Ogbonna-Joseph/Thingy-Design/Image/design00001.png

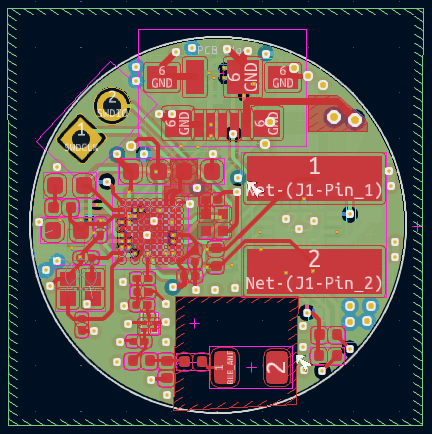
Image/design00001.png
