Ogbonna-Joseph/Thingy-Design/Image/3d007.png

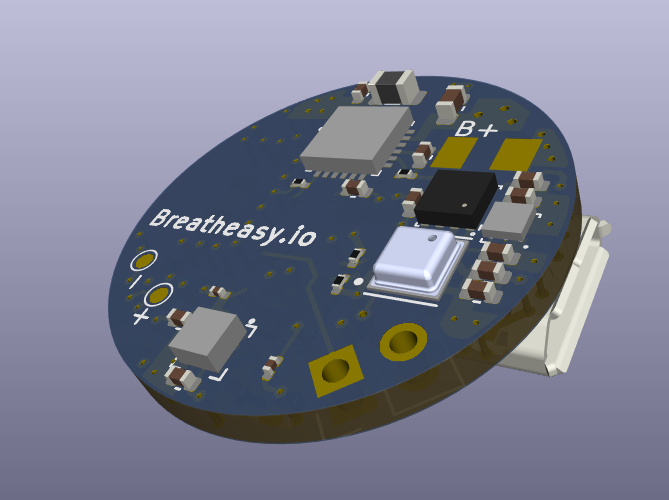
Image/3d007.png
