Ogbonna-Joseph/Thingy-Design/Image/3d002.png

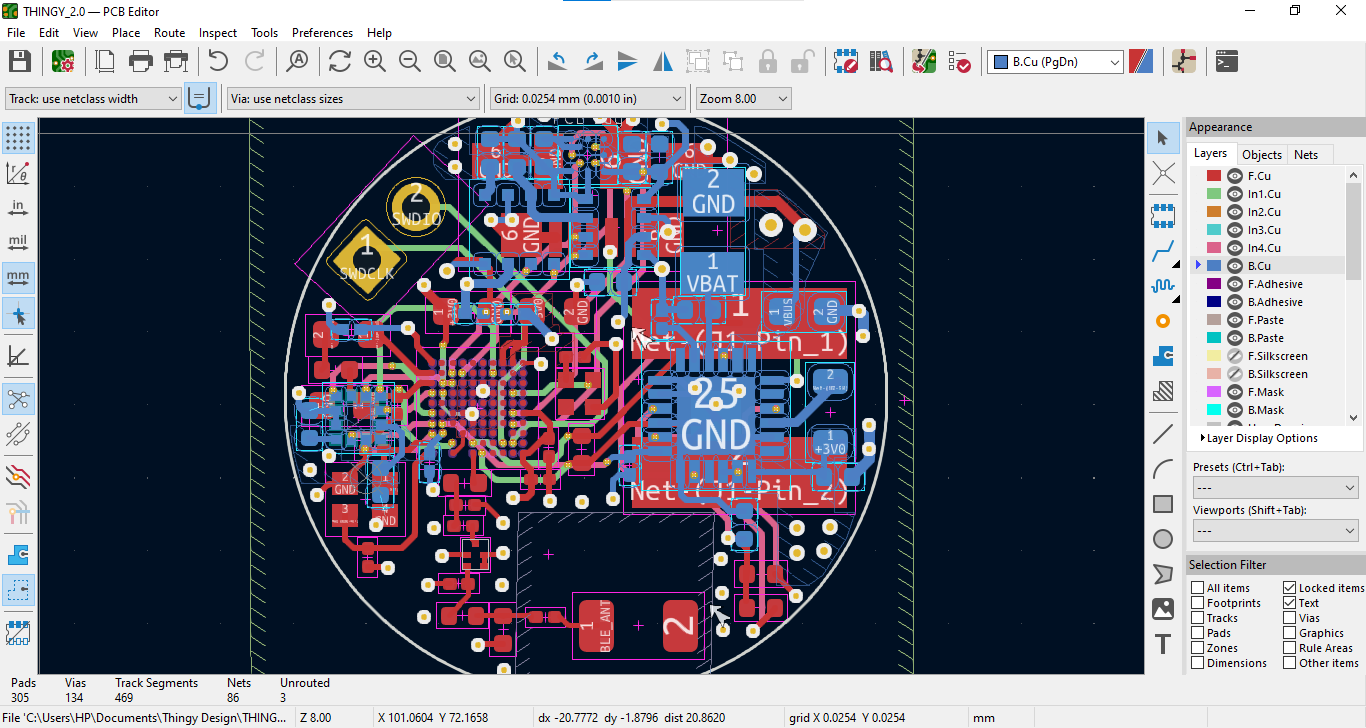
Image/3d002.png
