Ogbonna-Joseph/Thingy-Design/Image/3d003.png

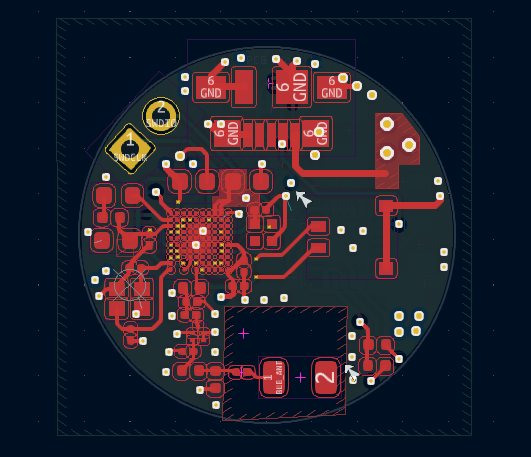
Image/3d003.png
