Ogbonna-Joseph/Thingy-Design/Image/3d004.png

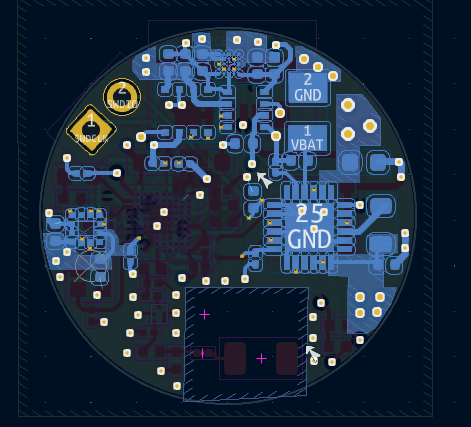
Image/3d004.png
