Ogbonna-Joseph/Thingy-Design/Image/3d005.png

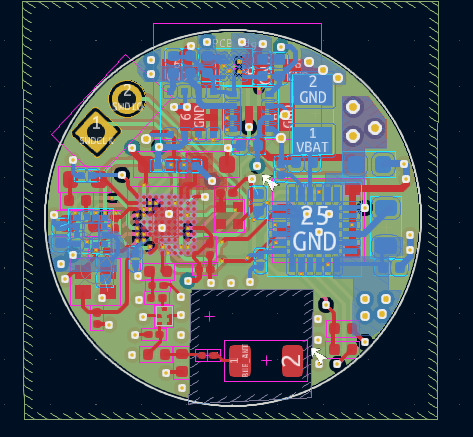
Image/3d005.png
