Ogbonna-Joseph/Thingy-Design/Image/3d006.png

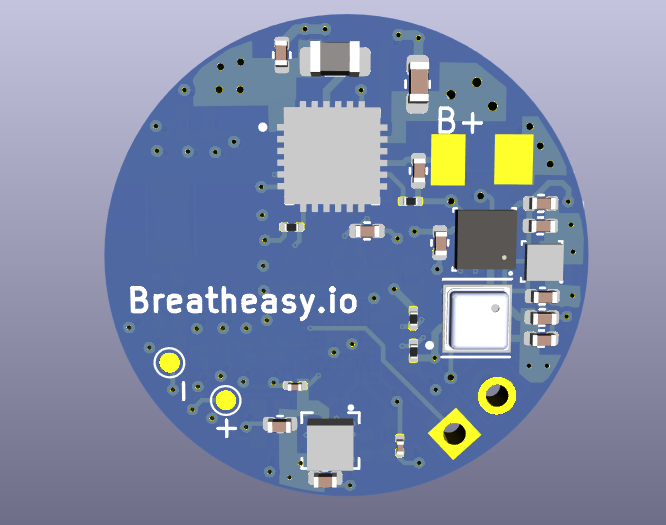
Image/3d006.png
