Ogbonna-Joseph/Thingy-Design/Image/3d008.png

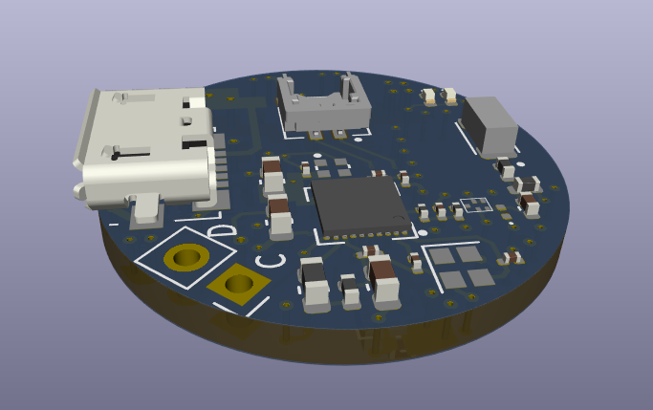
Image/3d008.png
