Ogbonna-Joseph/Thingy-Design/Image/3d009.png

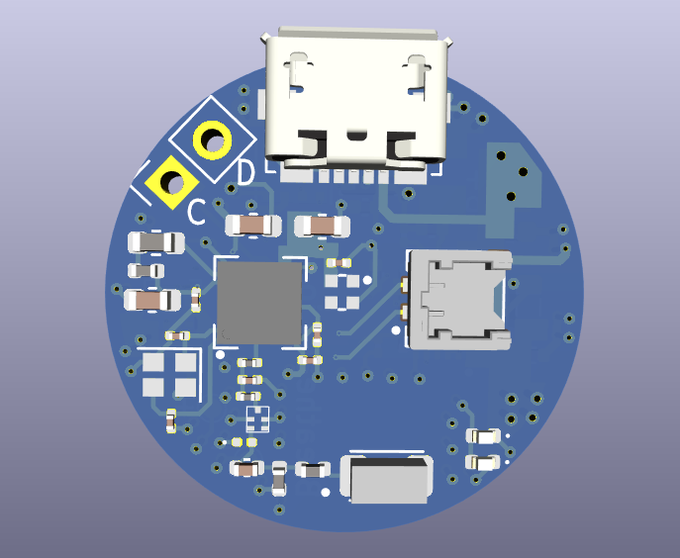
Image/3d009.png
