Ogbonna-Joseph/Thingy-Design/Image/design0001.png

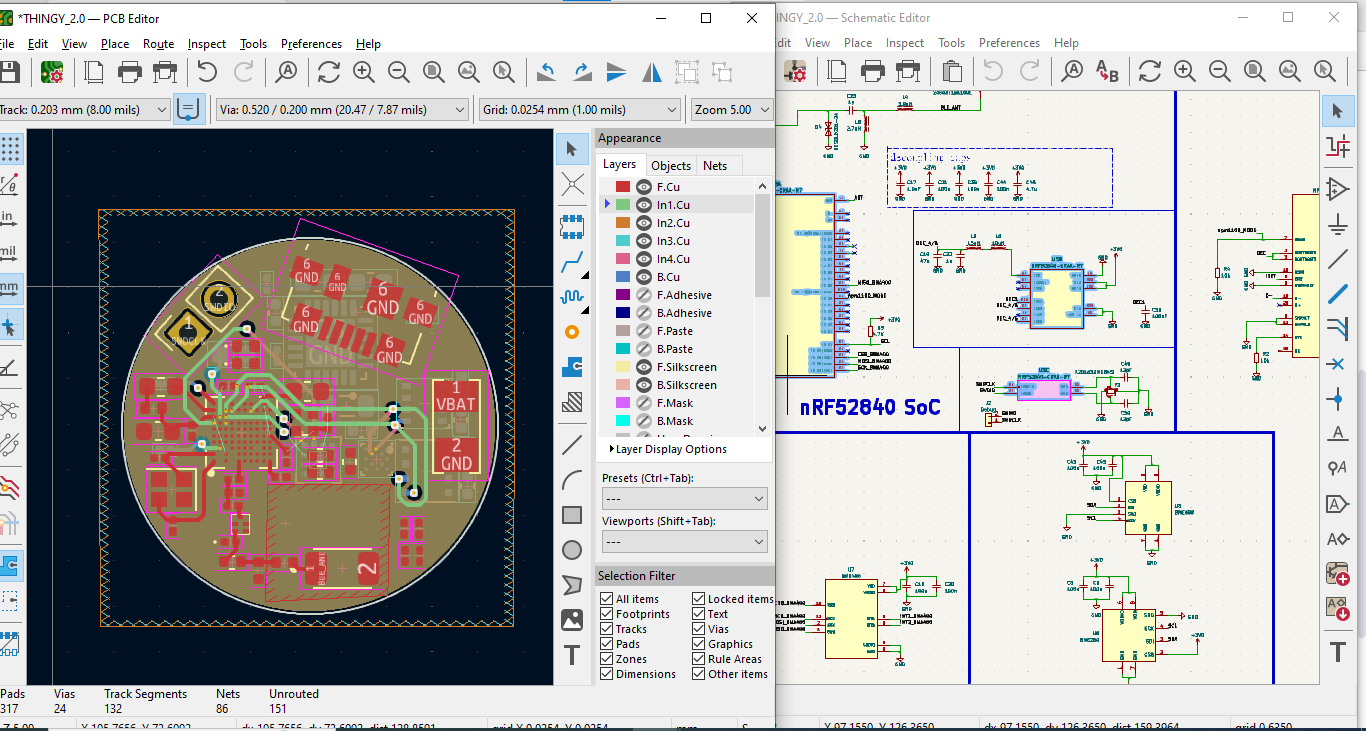
Image/design0001.png
