Ogbonna-Joseph/Thingy-Design/Image/design002.png

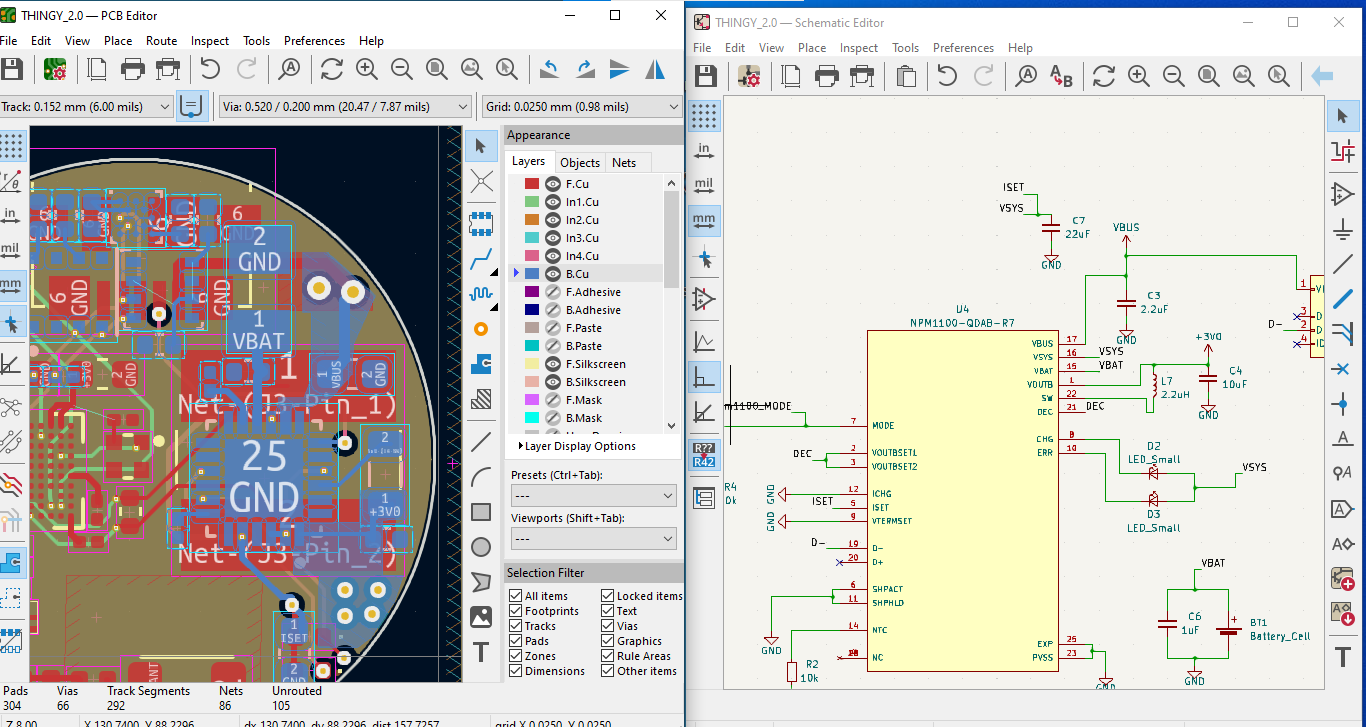
Image/design002.png
