Ogbonna-Joseph/Thingy-Design/Image/Impedence.png

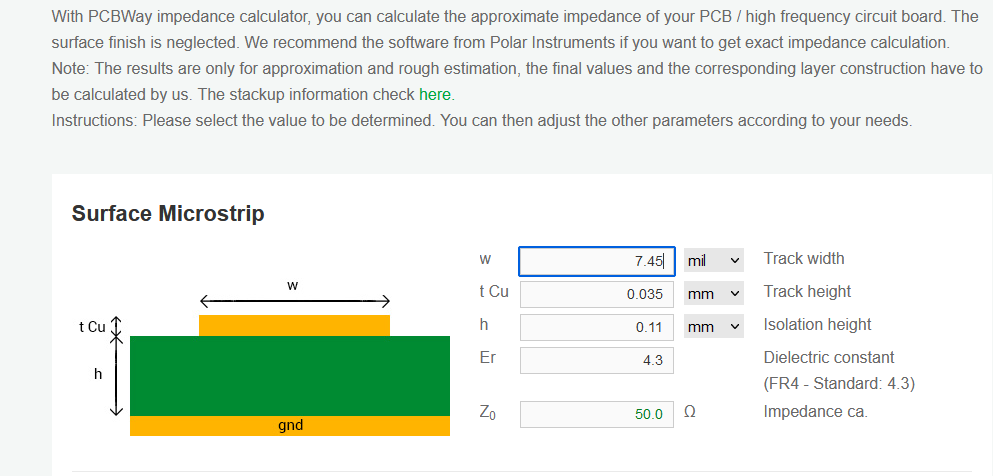
Image/Impedence.png
