Ogbonna-Joseph/Thingy-Design/Image/pcb001.png

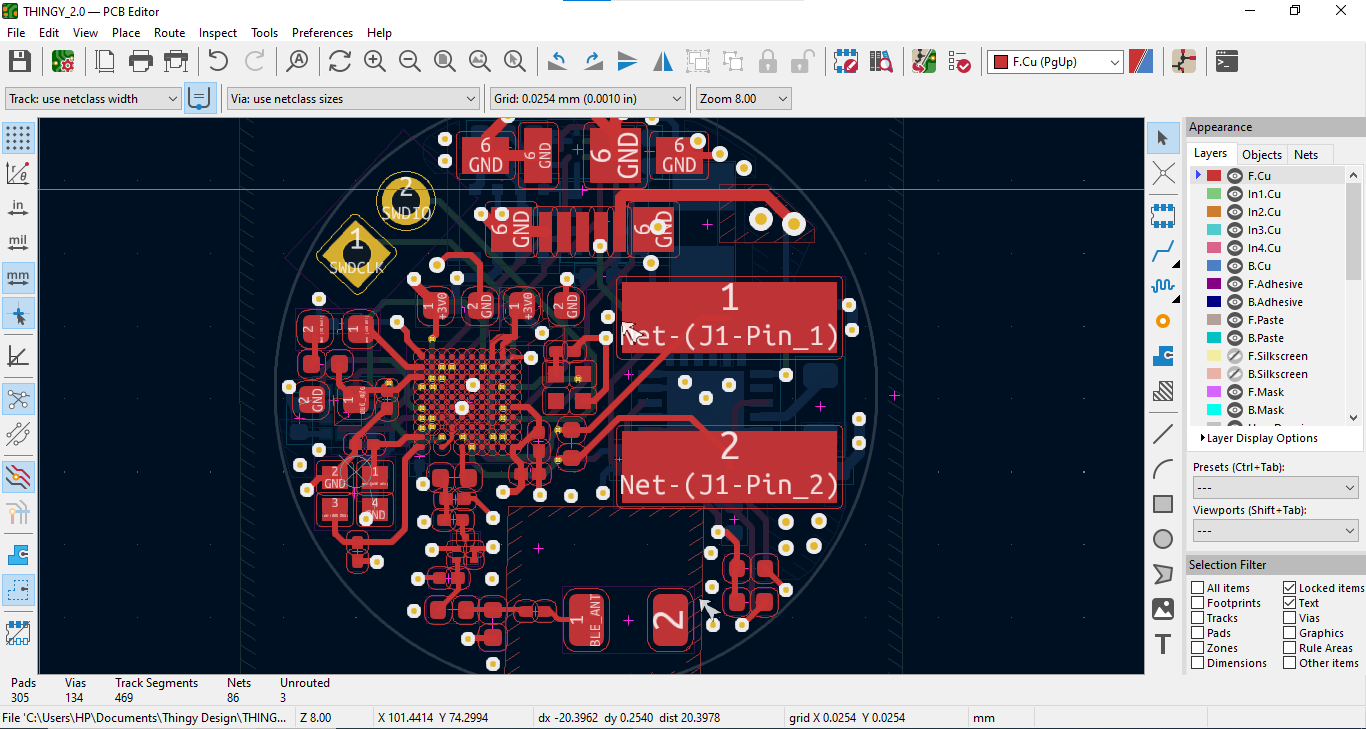
Image/pcb001.png
