Ogbonna-Joseph/Thingy-Design/Image/stackup.png

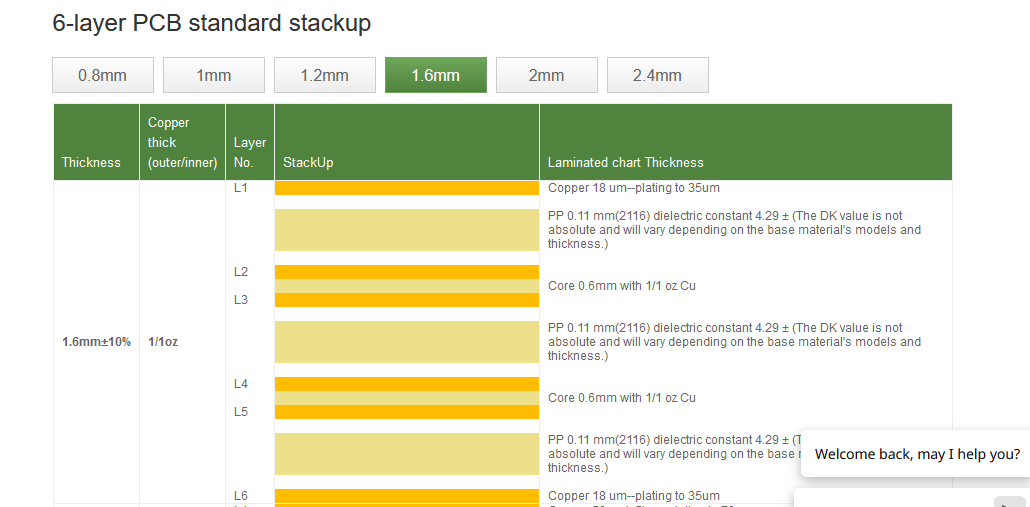
Image/stackup.png
