Ogbonna-Joseph/Thingy-Design/Symbols and Footprint Libs/2450AT18A100E/2450AT18A100E.step

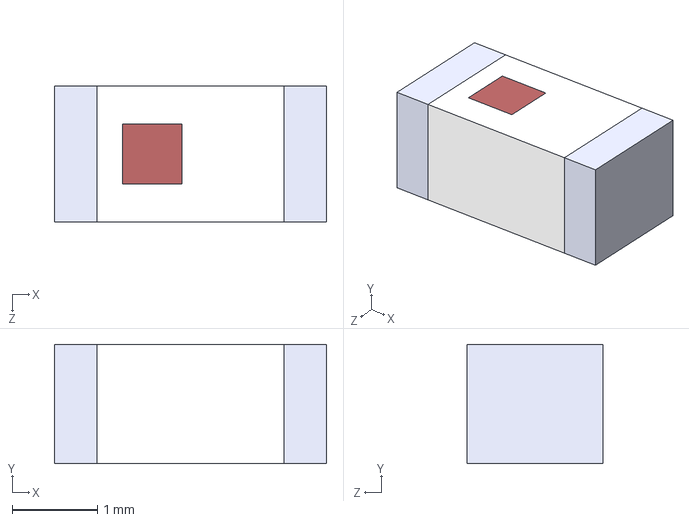
[picture p15: CAD file, 2023-09-10]
Symbols and Footprint Libs/2450AT18A100E/2450AT18A100E.step
3.20 x 1.40 x 1.60 mm
