Ogbonna-Joseph/Thingy-Design/Symbols and Footprint Libs/2450AT18D0100E/2450AT18D0100E.step

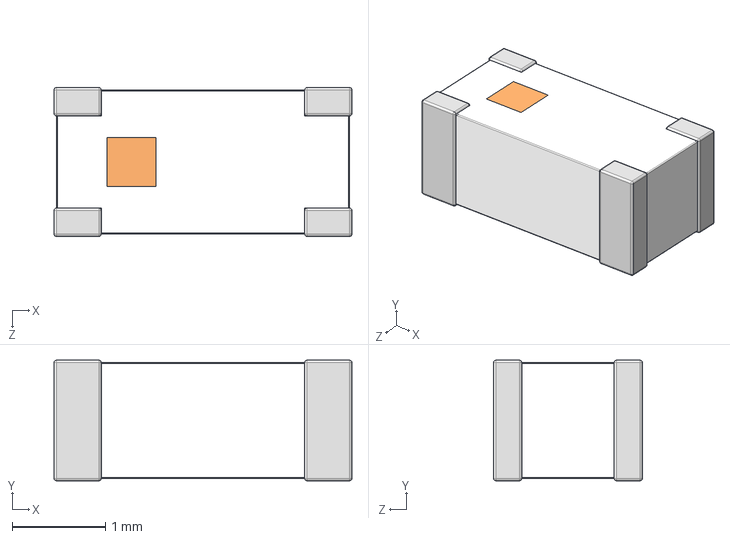
[picture p16: CAD file, 2023-09-10]
Symbols and Footprint Libs/2450AT18D0100E/2450AT18D0100E.step
3.20 x 1.30 x 1.60 mm
