Ogbonna-Joseph/Thingy-Design/Symbols and Footprint Libs/BM02B-ACHSS-GAN-TF_LF__SN_/BM02B-ACHSS-GAN-TF_LF__SN_.step

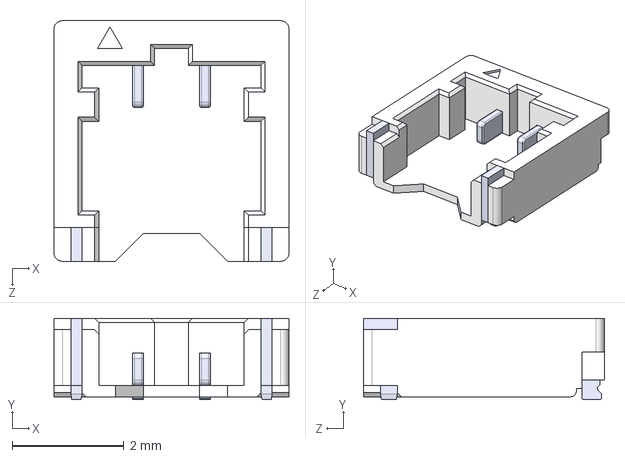
[picture p17: CAD file, 2023-09-10]
Symbols and Footprint Libs/BM02B-ACHSS-GAN-TF_LF__SN_/BM02B-ACHSS-GAN-TF_LF__SN_.step
4.20 x 1.45 x 4.30 mm
