Ogbonna-Joseph/Thingy-Design/Symbols and Footprint Libs/BMA400/BMA400.step

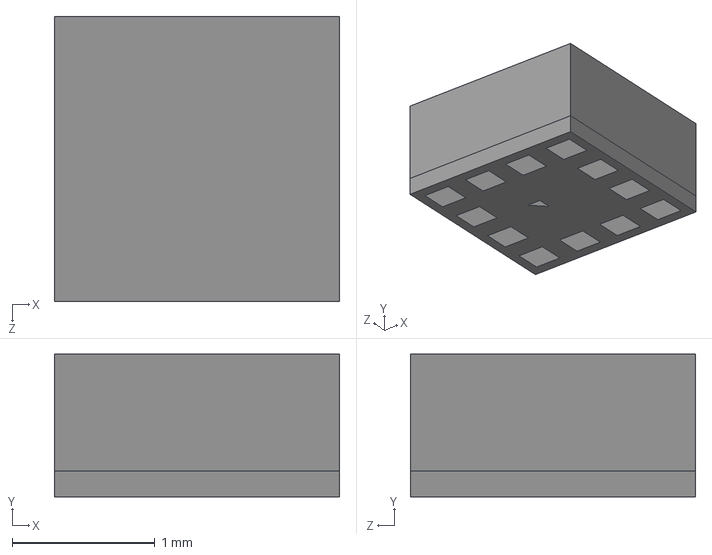
[picture p18: CAD file, 2023-09-10]
Symbols and Footprint Libs/BMA400/BMA400.step
2.00 x 1.00 x 2.00 mm
