Ogbonna-Joseph/Thingy-Design/Symbols and Footprint Libs/BME280/BME280.step

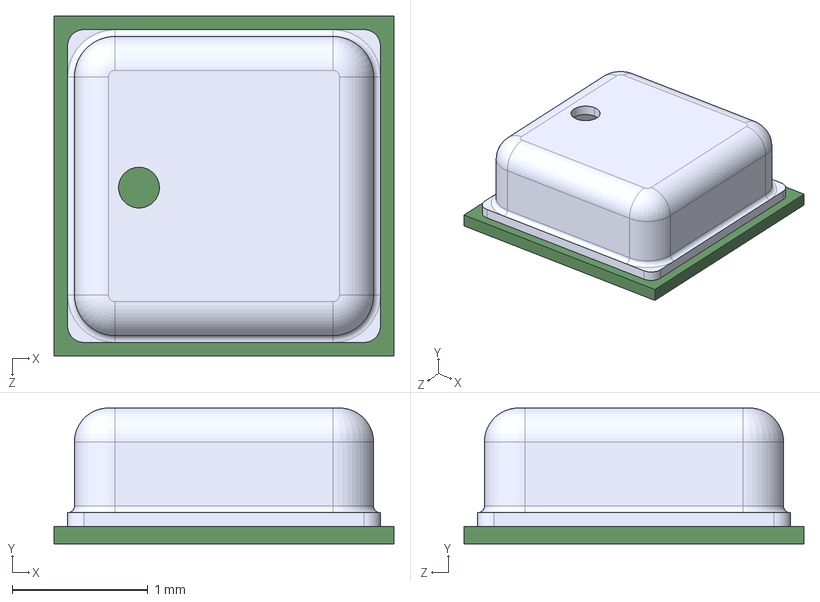
[picture p19: CAD file, 2023-09-10]
Symbols and Footprint Libs/BME280/BME280.step
2.50 x 1.00 x 2.50 mm
