Ogbonna-Joseph/Thingy-Design/Symbols and Footprint Libs/BME688/BME688.step

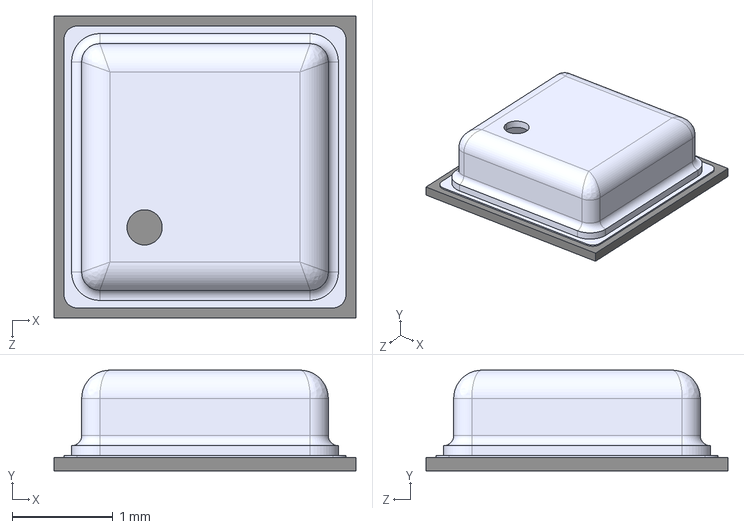
[picture p20: CAD file, 2023-09-10]
Symbols and Footprint Libs/BME688/BME688.step
3.00 x 1.00 x 3.00 mm
