Ogbonna-Joseph/Thingy-Design/Symbols and Footprint Libs/BMM150/BMM150.step

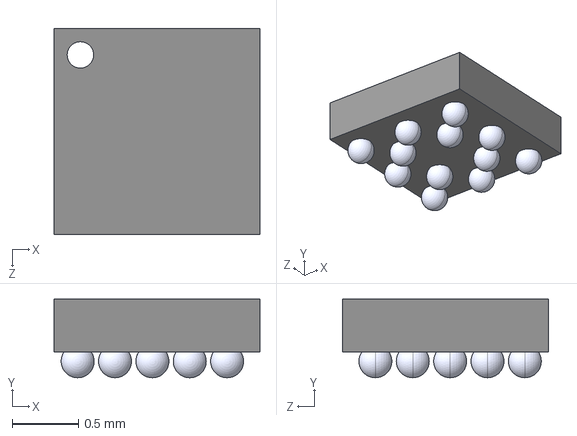
[picture p21: CAD file, 2023-09-10]
Symbols and Footprint Libs/BMM150/BMM150.step
1.56 x 0.595 x 1.56 mm
Body^BMM150
Pin^BMM150 x 12
