Ogbonna-Joseph/Thingy-Design/Symbols and Footprint Libs/EZA-EG1N50AC/EZA-EG1N50AC.step

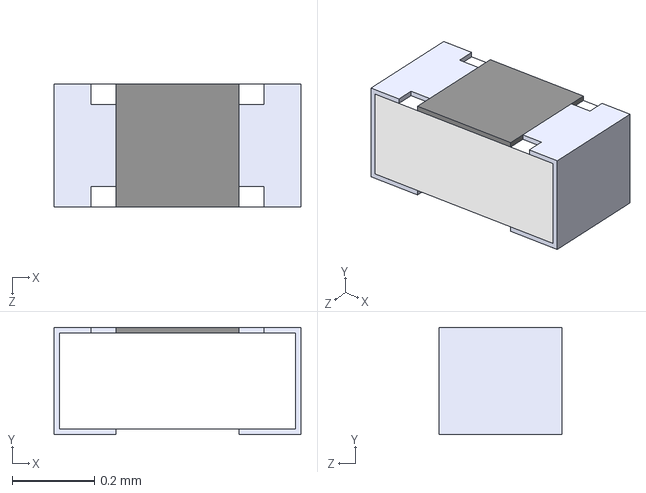
[picture p22: CAD file, 2023-09-10]
Symbols and Footprint Libs/EZA-EG1N50AC/EZA-EG1N50AC.step
0.6 x 0.26 x 0.3 mm
