Ogbonna-Joseph/Thingy-Design/Symbols and Footprint Libs/NPM1100-QDAB-R7/NPM1100-QDAB-R7.step

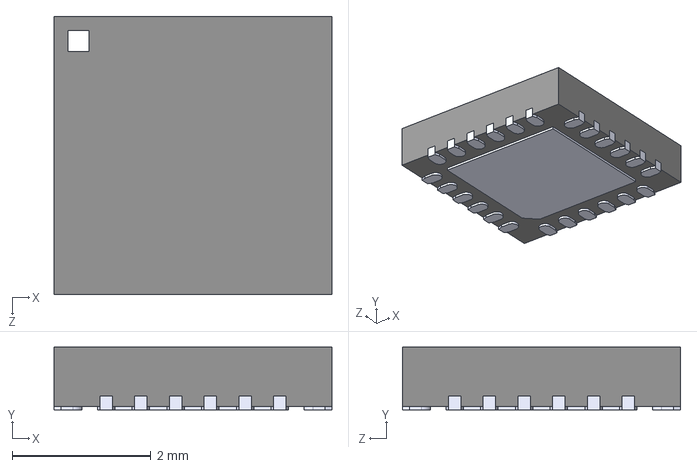
[picture p23: CAD file, 2023-09-10]
Symbols and Footprint Libs/NPM1100-QDAB-R7/NPM1100-QDAB-R7.step
4.00 x 0.9 x 4.00 mm
