Ogbonna-Joseph/Thingy-Design/Symbols and Footprint Libs/X201632MKB4SI.stp

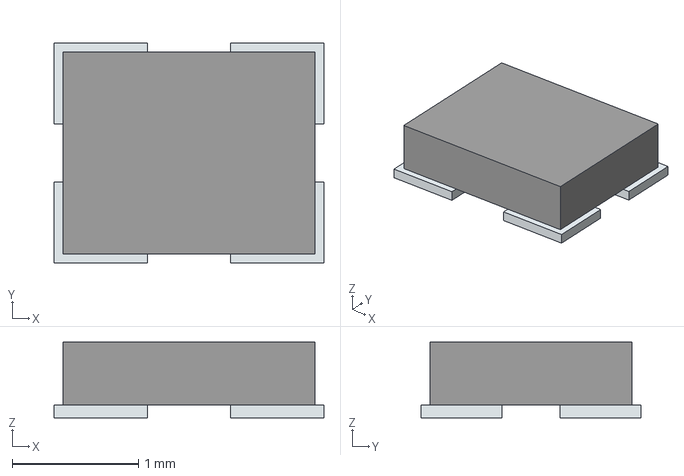
[picture p24: CAD file, 2023-09-10]
Symbols and Footprint Libs/X201632MKB4SI.stp
2.14 x 1.74 x 0.6 mm
Pins
