Ogbonna-Joseph/Thingy-Design/Symbols and Footprint Libs/NRF52840-CKAA-R7.stp

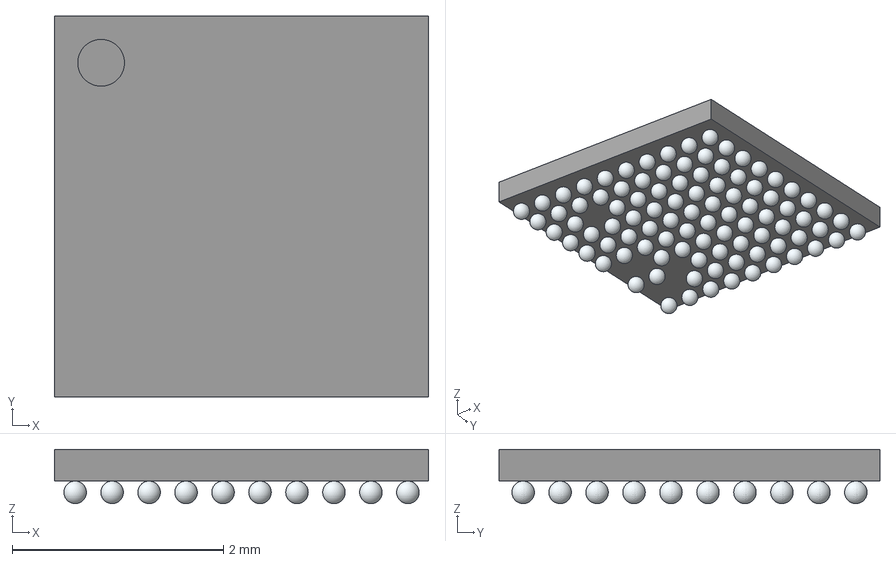
[picture p25: CAD file, 2023-09-10]
Symbols and Footprint Libs/NRF52840-CKAA-R7.stp
3.54 x 3.61 x 0.514 mm
A1
A2
A3
A4
A5
A6
A7
A8
A9
A10
B3
B4
B5
B6
B7
B8
B9
B10
C1
C2
C4
C5
C6
C7
C8
C9
C10
D3
D4
D5
D6
D7
D8
D9
D10
E1
E2
E3
E4
E5
E6
E7
E8
E9
E10
F1
F2
F3
F4
F5
F6
F7
F8
F9
F10
G1
G2
G3
G4
G5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
