Ogbonna-Joseph/Thingy-Design/THINGY_2.0_Sch.pdf

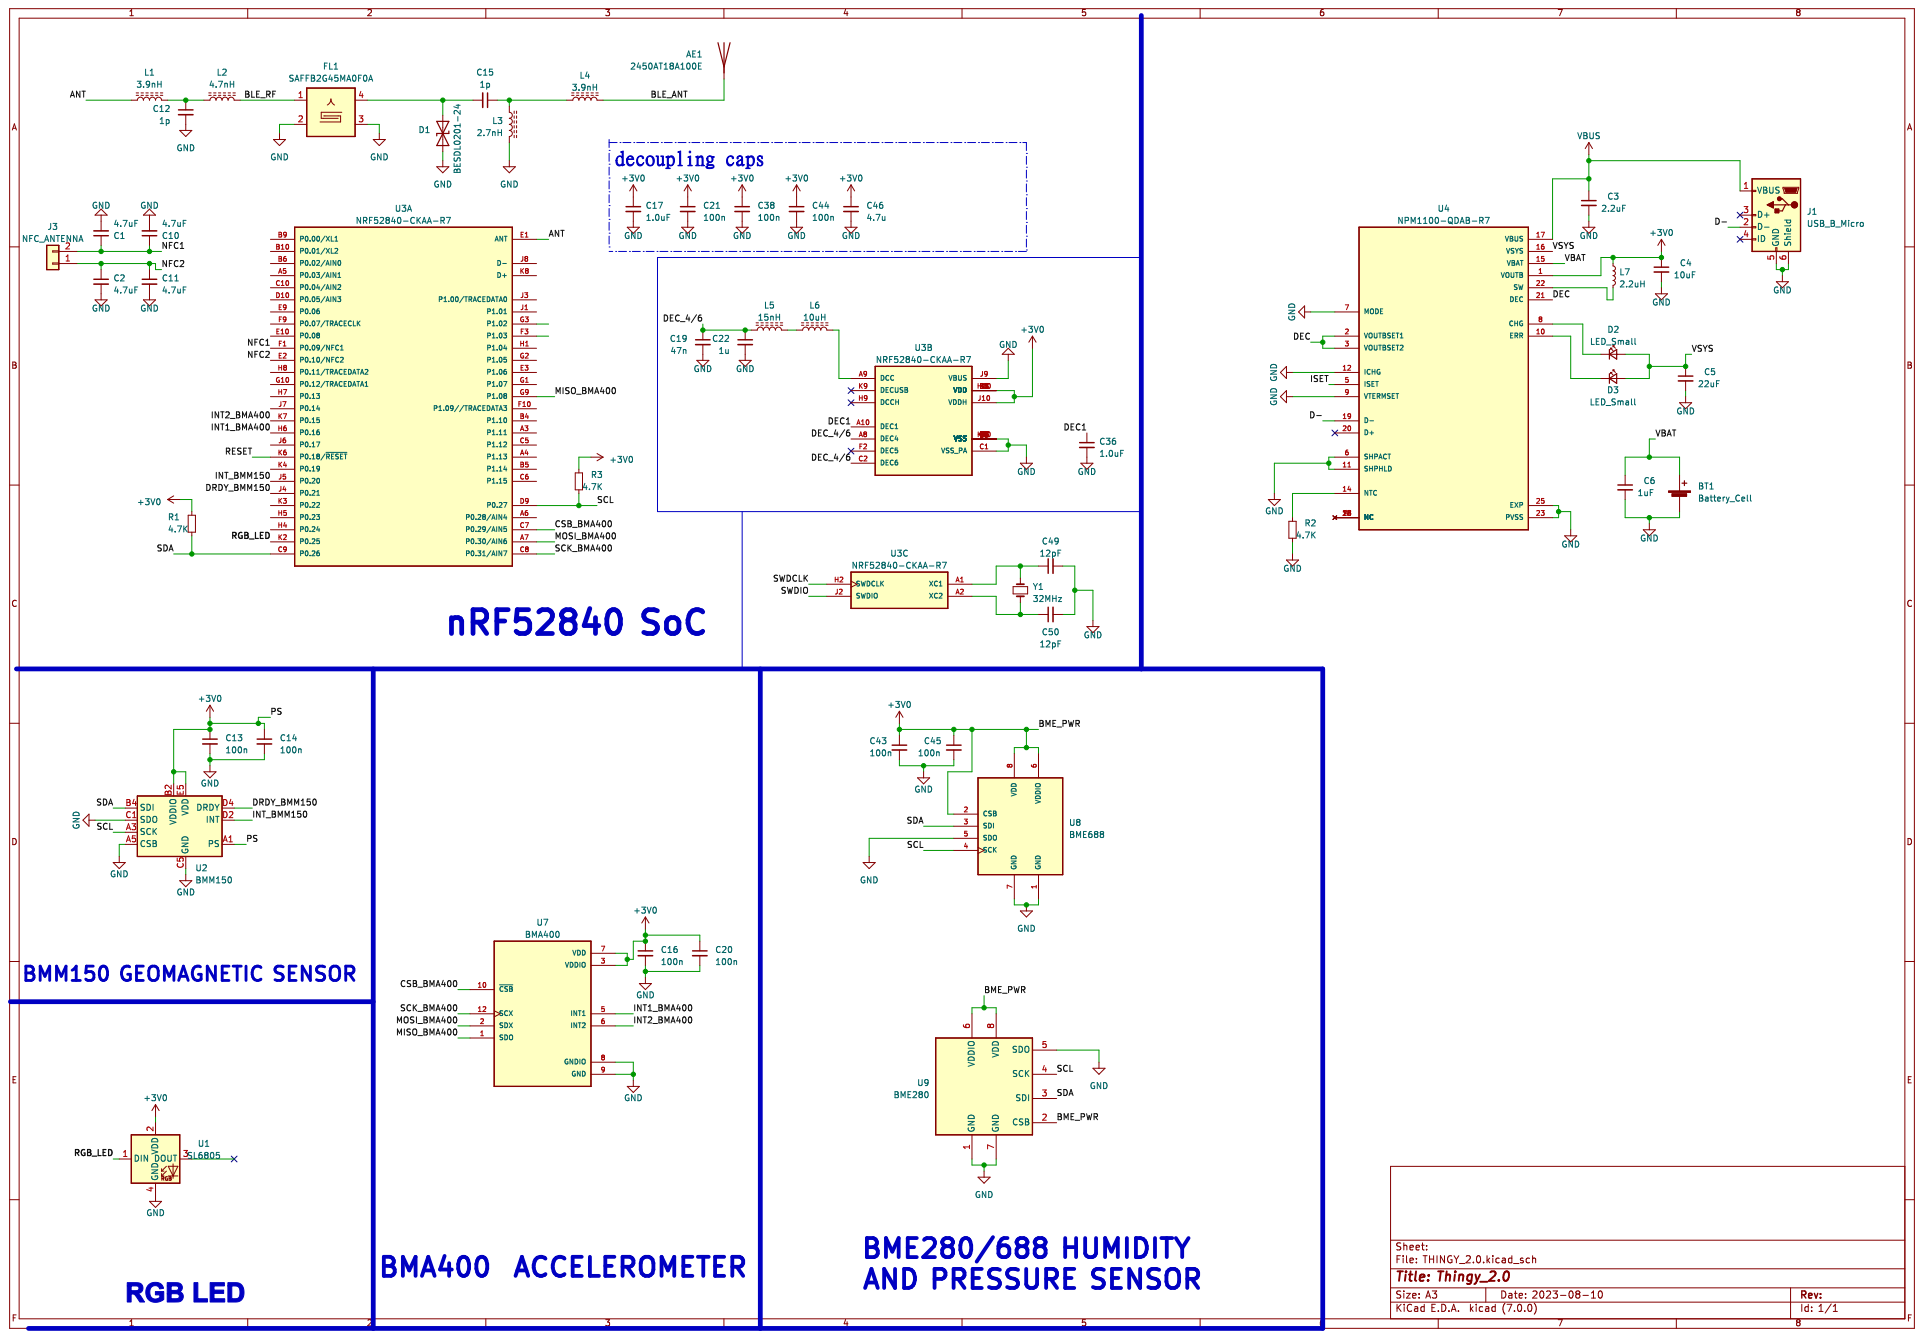
[picture p30: page 1]
