Ogbonna-Joseph/Thingy-Design/THINGY_2.0/THINGY_2.0.kicad_pcb

## KiCad design THINGY_2.0/THINGY_2.0.kicad_pcb (2023-09-10)

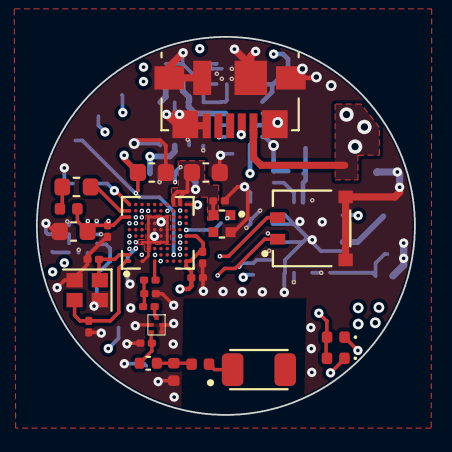
[picture p31: board THINGY_2.0.kicad_pcb from above]

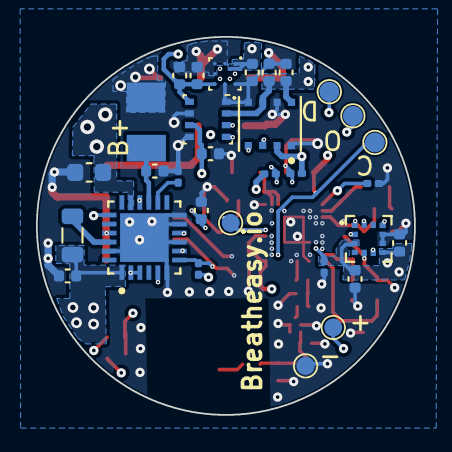
[picture p32: board THINGY_2.0.kicad_pcb from below]

Board: 6 copper layers, 21.0 x 21.0 mm, 58 parts (31 on the bottom side), 41 nets.

Parts:
3V0, 3V0#2: 3V0; TestPoint_Pad_D0.9mm
AE1: 2450AT18A100E; ANTC3216X140N
BT1: Battery_Cell; PinSocket_2x01_P2.54mm_Vertical_SMD
C1: 1p; C_0201_0603Metric
C3, C9, C12, C14: 100n; C_0201_0603Metric
C4, C5, C8, C10, C16, C17, C18, C19: 100n; C_0402_1005Metric
C6: 1p; C_0402_1005Metric
C7: 1.0uF; C_0603_1608Metric
C11: 47n; C_0201_0603Metric
C13: 1u; C_0603_1608Metric
C15: 4.7u; C_0603_1608Metric
C20, C21: 8pF; C_0201_0603Metric
C22: 100nF; C_0201_0603Metric
C23: 22uF; C_0402_1005Metric
C24: 2.2uF; C_0603_1608Metric
C25: 1uF; C_0402_1005Metric
C26: 10uF; C_0402_1005Metric
D1: BESDL0201-24; D_0201_0603Metric
D2, D3: LED_Small; LED_0402_1005Metric
FL1: SAFFB2G45MA0F0A
Gnd: Gnd; TestPoint_Pad_D0.9mm
Gnd#2, Gnd#3, Gnd#4: Gnd; TestPoint_Pad_D0.9mm
J1: BM02B-ACHSS-GAN-TF(LF)(SN); JST_BM02B-ACHSS-GAN-TF(LF)(SN)
J3: USB_B_Micro; USB_Micro-B_Molex_47346-0001
L1: 3.9nH; L_0201_0603Metric
L2: 4.7nH; L_0201_0603Metric
L3: 2.7nH; L_0402_1005Metric
L4: 3.9nH; L_0402_1005Metric
L5: 15nH; L_0402_1005Metric
L6: 10uH; L_0603_1608Metric
L7: 2.2uH; L_0805_2012Metric
R1, R2: 4.7K; R_0201_0603Metric
R3, R4: 10k; R_0201_0603Metric
U1: SL6805; SL680555
U2: BMM150; WLCSP-12_1.56x1.56mm_P0.4mm
U3: NRF52840-CKAA-R7; BGA94N35P10X10_360X354X51N
U4: BMA400; XDCR_BMA400
U5: BME280; Bosch_LGA-8_2.5x2.5mm_P0.65mm_ClockwisePinNumbering
U6: BME688; IC_BME688
U7: NPM1100-QDAB-R7; QFN50P400X400X90-25N
Y1: X201632MKB4SI; Crystal_SMD_2016-4Pin_2.0x1.6mm

Connections:
+3V0: 3V0#2.1, C3.1, C4.1, C5.1, C7.1, C8.1, C9.1, C10.1, C12.1, C14.1, C15.1, C16.1, C17.1, C18.1, C19.1, C26.1, L7.1, R1.1, R2.1, R3.2, U1.2 (VDD), U2.A1 (PS), U2.B2 (VDDIO), U2.E5 (VDD), U3.B3 (VDD), U3.B8 (VDD), U3.H10 (VDD), U3.J10 (VDDH), U3.K1 (VDD), U3.K5 (VDD), U4.3 (VDDIO), U4.7 (VDD), U5.2 (CSB), U5.6 (VDDIO), U5.8 (VDD), U6.2 (CSB), U6.6 (VDDIO), U6.8 (VDD), U7.1 (VOUTB)
/ANT: L1.2, U3.E1 (ANT)
/BLE_ANT: AE1.1 (A), L4.1
/BLE_RF: FL1.1, L2.1
/CSB_BMA400: U3.A5 (P0.03/AIN1), U4.10 (~CSB)
/D-: J3.2 (D-), U7.19 (D-)
/DEC: U7.2 (VOUTBSET1), U7.3 (VOUTBSET2), U7.21 (DEC)
/DEC1: C22.1, U3.A10 (DEC1)
/DEC_4/6: C11.1, C13.1, L5.2, U3.A8 (DEC4), U3.C2 (DEC6)
/DRDY_BMM150: U2.D4 (DRDY), U3.J5 (P0.20)
/INT1_BMA400: U3.A3 (P1.11), U4.5 (INT1)
/INT2_BMA400: U3.A4 (P1.13), U4.6 (INT2)
/INT_BMM150: U2.D2 (INT), U3.J4 (P0.21)
/ISET: C23.1, D2.2 (A), D3.2 (A), U7.5 (ISET), U7.16 (VSYS)
/MISO_BMA400: U3.G9 (P1.08), U4.1 (SDO)
/MOSI_BMA400: U3.A7 (P0.30/AIN6), U4.2 (SDX)
/RESET: 3V0.1, U3.K6 (P0.18/~RESET)
/RGB_LED: U1.1 (DIN), U3.J7 (P0.14)
/SCK_BMA400: U3.C8 (P0.31/AIN7), U4.12 (SCX)
/SCL: R2.2, U2.A3 (SCK), U3.D9 (P0.27), U5.4 (SCK), U6.4 (SCK)
/SDA: R1.2, U2.B4 (SDI), U3.C9 (P0.26), U5.3 (SDI), U6.3 (SDI)
/SWDCLK: Gnd#3.3 (1), U3.H2 (SWDCLK)
/SWDIO: Gnd#4.1, U3.J2 (SWDIO)
/SWO: Gnd.2 (1), U3.J3 (P1.00/TRACEDATA0)
/VBAT: BT1.1 (+), C25.1, U7.15 (VBAT)
/npm1100_MODE: R3.1, U3.B4 (P1.10), U7.7 (MODE)
GND: BT1.2 (-), C1.2, C3.2, C4.2, C5.2, C7.2, C8.2, C9.2, C10.2, C11.2, C12.2, C13.2, C14.2, C15.2, C16.2, C17.2, C18.2, C19.2, C20.2, C21.2, C22.2, C23.2, C24.2, C25.2, C26.2, D1.1 (A1), FL1.2, FL1.3, FL1.5, Gnd#2.1, J1.S1 (SHIELD), J1.S2 (SHIELD), J3.5 (GND), J3.6 (Shield), L3.1, R4.2, U1.4 (GND), U2.A5 (CSB), U2.C1 (SDO), U2.C5 (GND), U2.E1 (GND), U2.E3 (GND), U3.B7 (VSS), U3.C1 (VSS_PA), U3.C4 (VSS), U3.D3 (VSS), U3.D4 (VSS), U3.D5 (VSS), U3.D6 (VSS), U3.D7 (VSS), U3.D8 (VSS), U3.E4 (VSS), U3.E5 (VSS), U3.E6 (VSS), U3.E7 (VSS), U3.E8 (VSS), U3.F4 (VSS), U3.F5 (VSS), U3.F6 (VSS), U3.F7 (VSS), U3.F8 (VSS), U3.G4 (VSS), U3.G5 (VSS), U3.G6 (VSS), U3.G7 (VSS), U3.G8 (VSS), U3.J9 (VBUS), U3.K10 (VSS), U4.8 (GNDIO), U4.9 (GND), U5.1 (GND), U5.5 (SDO), U5.7 (GND), U6.1 (GND), U6.5 (SDO), U6.7 (GND), U7.6 (SHPACT), U7.9 (VTERMSET), U7.11 (SHPHLD), U7.12 (ICHG), U7.23 (PVSS), U7.25 (EXP), Y1.2, Y1.4
unnamed: C1.1, L1.1, L2.2
unnamed: C6.1, L3.2, L4.2
unnamed: C6.2, D1.2 (A2), FL1.4
unnamed: D2.1 (K), U7.8 (CHG)
unnamed: D3.1 (K), U7.10 (ERR)
unnamed: L5.1, L6.2
unnamed: J1.1, U3.F1 (P0.09/NFC1)
unnamed: J1.2, U3.E2 (P0.10/NFC2)
unnamed: L6.1, U3.A9 (DCC)
unnamed: C20.1, U3.A1 (XC1), Y1.3
unnamed: C21.1, U3.A2 (XC2), Y1.1
unnamed: R4.1, U7.14 (NTC)
unnamed: L7.2, U7.22 (SW)
VBUS: C24.1, J3.1 (VBUS), U7.17 (VBUS)
